jnedbal/MicroFLiC_power_supply_1_1/MicroFLiC_power_supply.kicad_pcb

## KiCad design MicroFLiC_power_supply.kicad_pcb (2016-03-18)

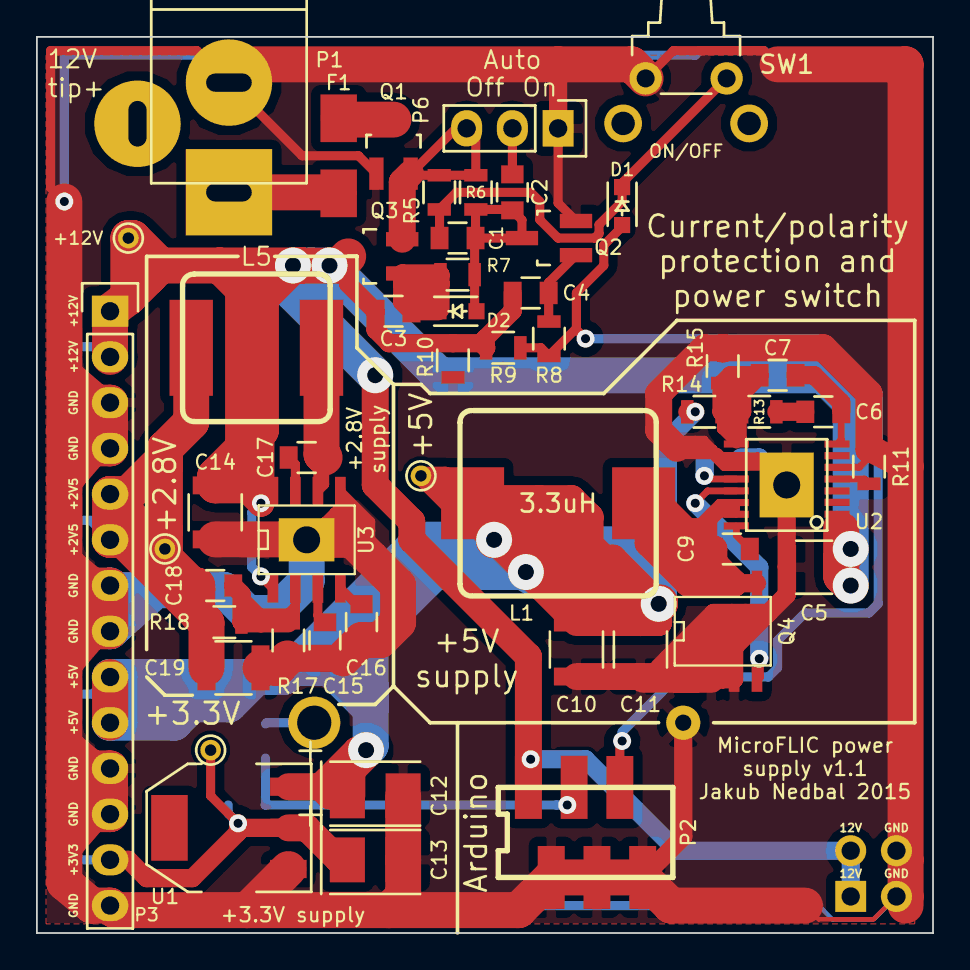
[picture p1: board MicroFLiC_power_supply.kicad_pcb from above]

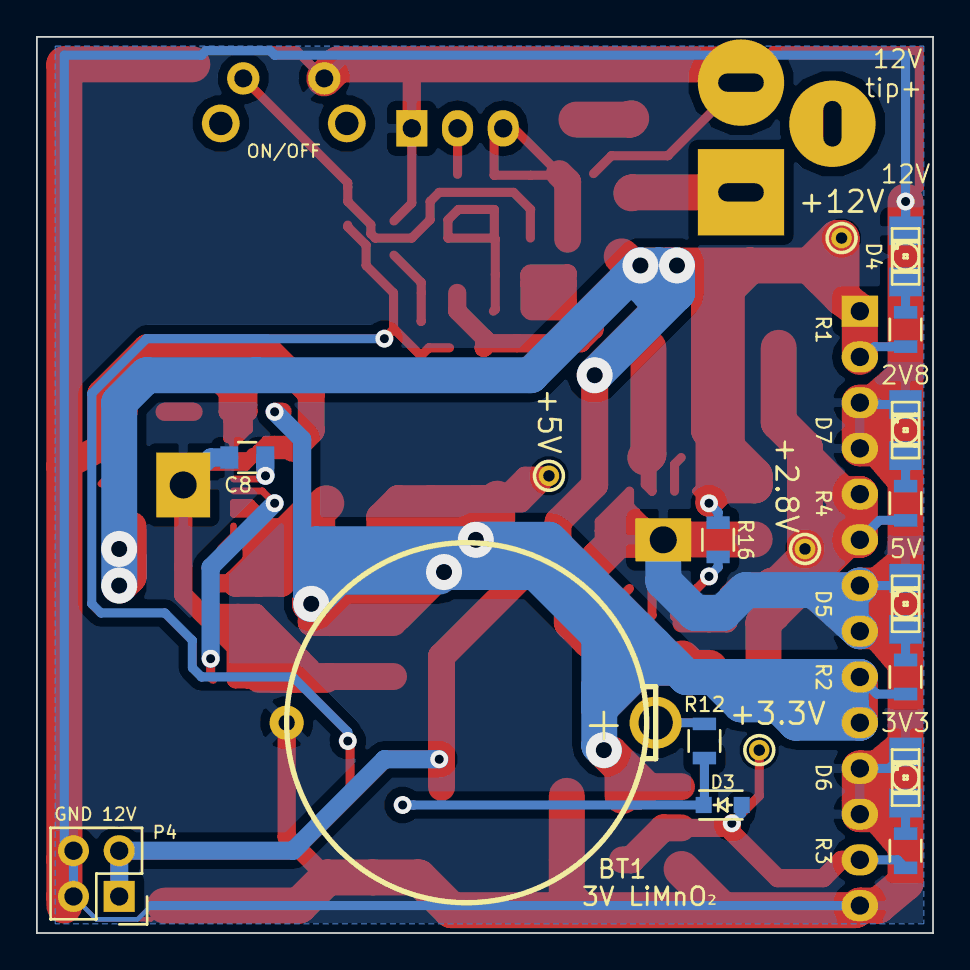
[picture p2: board MicroFLiC_power_supply.kicad_pcb from below]

Board: 2 copper layers, 49.8 x 49.8 mm, 65 parts (14 on the bottom side), 34 nets.

Parts:
BT1: 3V LiMnO₂; ML2016
C1, C8, C15: 1u/50V; C_0805
C2, C9, C17: 100n; C_0805
C3: 10n; C_0805
C4: 4u7/25V; C_0805
C5, C14: 22u/25V; C_1210
C6: 680p; C_0805
C7: 1p5; C_0805
C10, C11, C19: 47u/16V; C_1210
C12, C13: 10u/10V/0.15Ω<ESR<0.5Ω; TantalC_SizeB_EIA-3528_Reflow
C16: 8n2; C_0805
C18: 4p7; C_0805
D1, D2, D3: 1N4148; SOD-323
D4, D5, D6, D7: LED; LED-1206
F1: F5A; Fuse_SMD1206_HandSoldering
L1: 3.3uH; IHLP-4040DZ-01
L5: 2.2uH; IHLP-3232CZ-11
P1: DC jack; JACK_ALIM
P2: 6-way Micro-MaTch; 7-188275-6
P3: 1x14 socket strip; ESQ-114-33-S-G
P4: 2x2 socket strip; ESQ-102-33-D-G
P6: 1x3 header strip; Pin_Header_Straight_1x03
PP1: +12V; PINTST
PP2: +5V; PINTST
PP3: +3.3V; PINTST
PP4: +2.8V; PINTST
Q1, Q3: SI2369; SOT23GDS
Q2: TSM2314; SOT23GDS
Q4: IRF8721; SO8_FDS6298
R1, R10, R16: 10k; R_0805
R2, R15: 3k; R_0805
R3: 1k5; R_0805
R4: 1k; R_0805
R5, R6, R7, R9: 100k; R_0805
R8: 270k; R_0805
R11, R13: 82k; R_0805
R12: 470R; R_0805
R14: 22k; R_0805
R17: 12k; R_0805
R18: 33k; R_0805
SW1: Tactile switch R/A; tactileSwitchRA
U1: AP1117E33; SOT-223
U2: ADP2381; SSOP-16(EP)
U3: TPS54428; PDSO8

Connections:
+2V5: C18.1, C19.1, L5.2, P3.5, P3.6, PP4.1, R4.1, R18.1
+3V3: C13.1, D3.2, P3.13, PP3.1, R3.1, U1.2
+5VP: C10.1, C11.1, C12.1, L1.2, P3.9, P3.10, PP2.1, R2.1, R14.1, U1.3
+12V: C3.1, C4.1, C5.1, C14.1, P2.1, P3.1, P3.2, P4.1, P4.2, PP1.1, Q3.D, R1.1, R9.1, R10.1, R16.1, U2.1, U2.2, U3.8
+BATT: D3.1, P2.3, R12.1
/Power Supply/BST: C9.1, U2.16
/Power Supply/C7R8: C6.2, R13.1
/Power Supply/COMP: C6.1, C7.1, U2.8
/Power Supply/EN: R16.2, U3.1
/Power Supply/FB: C7.2, R13.2, R14.2, R15.1, U2.9
/Power Supply/LD: Q4.G, U2.13
/Power Supply/RT: R11.2, U2.5
/Power Supply/SS: C16.1, U3.4
/Power Supply/SW2.8: C17.1, L5.1, U3.6
/Power Supply/SW5: C9.2, L1.1, Q4.D, U2.14, U2.15
/Power Supply/VBST: C17.2, U3.7
/Power Supply/VFB: C18.2, R17.1, R18.2, U3.2
/Power Supply/VREG2.8: C15.1, U3.3
/Power Supply/VREG5: C8.1, U2.12
/electronicSwitch/AUTO: C2.2, P6.2
/electronicSwitch/CURLIM: C3.2, D2.1, Q3.G, R7.2
/electronicSwitch/DELAYED_OFF: C4.2, Q2.G, R8.1
/electronicSwitch/MCU_OFF: D1.2, P2.5, R8.2, R9.2
/electronicSwitch/PUSHBUTTON: C1.2, D1.1, R5.2, SW1.2
/electronicSwitch/V_5AMP: F1.2, Q1.D
/electronicSwitch/V_IN: F1.1, P1.1
/electronicSwitch/V_PROTECTED: P6.3, Q1.S, Q3.S, R5.1, R6.1
GND: BT1.2, C5.2, C8.2, C10.2, C11.2, C12.2, C13.2, C14.2, C15.2, C16.2, C19.2, D4.1, D5.1, D6.1, D7.1, P1.2, P2.2, P2.4, P2.6, P3.3, P3.4, P3.7, P3.8, P3.11, P3.12, P3.14, P4.3, P4.4, P6.1, Q1.G, Q2.S, Q4.S, R10.2, R11.1, R15.2, R17.2, SW1.1, U1.1, U2.6, U2.10, U2.11, U2.17, U3.5, U3.9
unnamed: BT1.1, R12.2
unnamed: C1.1, C2.1, D2.2, Q2.D, R6.2, R7.1
unnamed: D4.2, R1.2
unnamed: D5.2, R2.2
unnamed: D6.2, R3.2
unnamed: D7.2, R4.2
