jnedbal/MicroFLiC_power_supply_1_1/(commit log)

2016-01-08 Fixed component references, diode orientation, part numbers
    [I2C_1_1.sch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]
2016-01-08 Got rid of useless files
    [I2C_1_1.sch, PowerSupply_1_0.sch, electronicSwitch_1_0.sch, shutterPWM_1_1.sch]
2016-01-19 Added load resistor. Changed part references in consequence.
    [MicroFLiC_power_supply_1_1.csv, MicroFLiC_power_supply_1_1.kicad_pcb, MicroFLiC_power_supply_1_1.sch, PowerSupply_1_1.sch, electronicSwitch_1_1.sch]
2016-02-19 Fixed 12k resistor, added .gitignore
    [MicroFLiC_power_supply_1_1.csv, PowerSupply_1_1.sch]
2016-02-22 Changed BAR43S diode into 1N4148 for minimum leakage current.
    [MicroFLiC_power_supply_1_1.csv, MicroFLiC_power_supply_1_1.kicad_pcb, PowerSupply_1_1.sch]
2016-03-02 Added detailed part descriptions
    [MicroFLiC_power_supply_1_1.csv, MicroFLiC_power_supply_1_1.kicad_pcb, MicroFLiC_power_supply_1_1.sch, PowerSupply_1_1.sch, electronicSwitch_1_1.sch]
2016-03-02 Renamed all files to remove version number
    [MicroFLiC_power_supply.csv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]
2016-03-10 Removed _1_1 suffix from filenames
    [MicroFLiC_power_supply.sch, PowerSupply.sch, electronicSwitch.sch]
2016-03-18 Changed SOD-323 package for easier soldering, fixed Avago->Broadcom LED manufacturer
    [MicroFLiC_power_supply.csv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]
